AlexanderFPhO/STM32H757-FC/(list of files, drawings)

Other design files:
freerouting.dsn
