AlexanderFPhO/STM32H757-FC/FC.kicad_pcb

## KiCad design FC.kicad_pcb (2025-06-13)

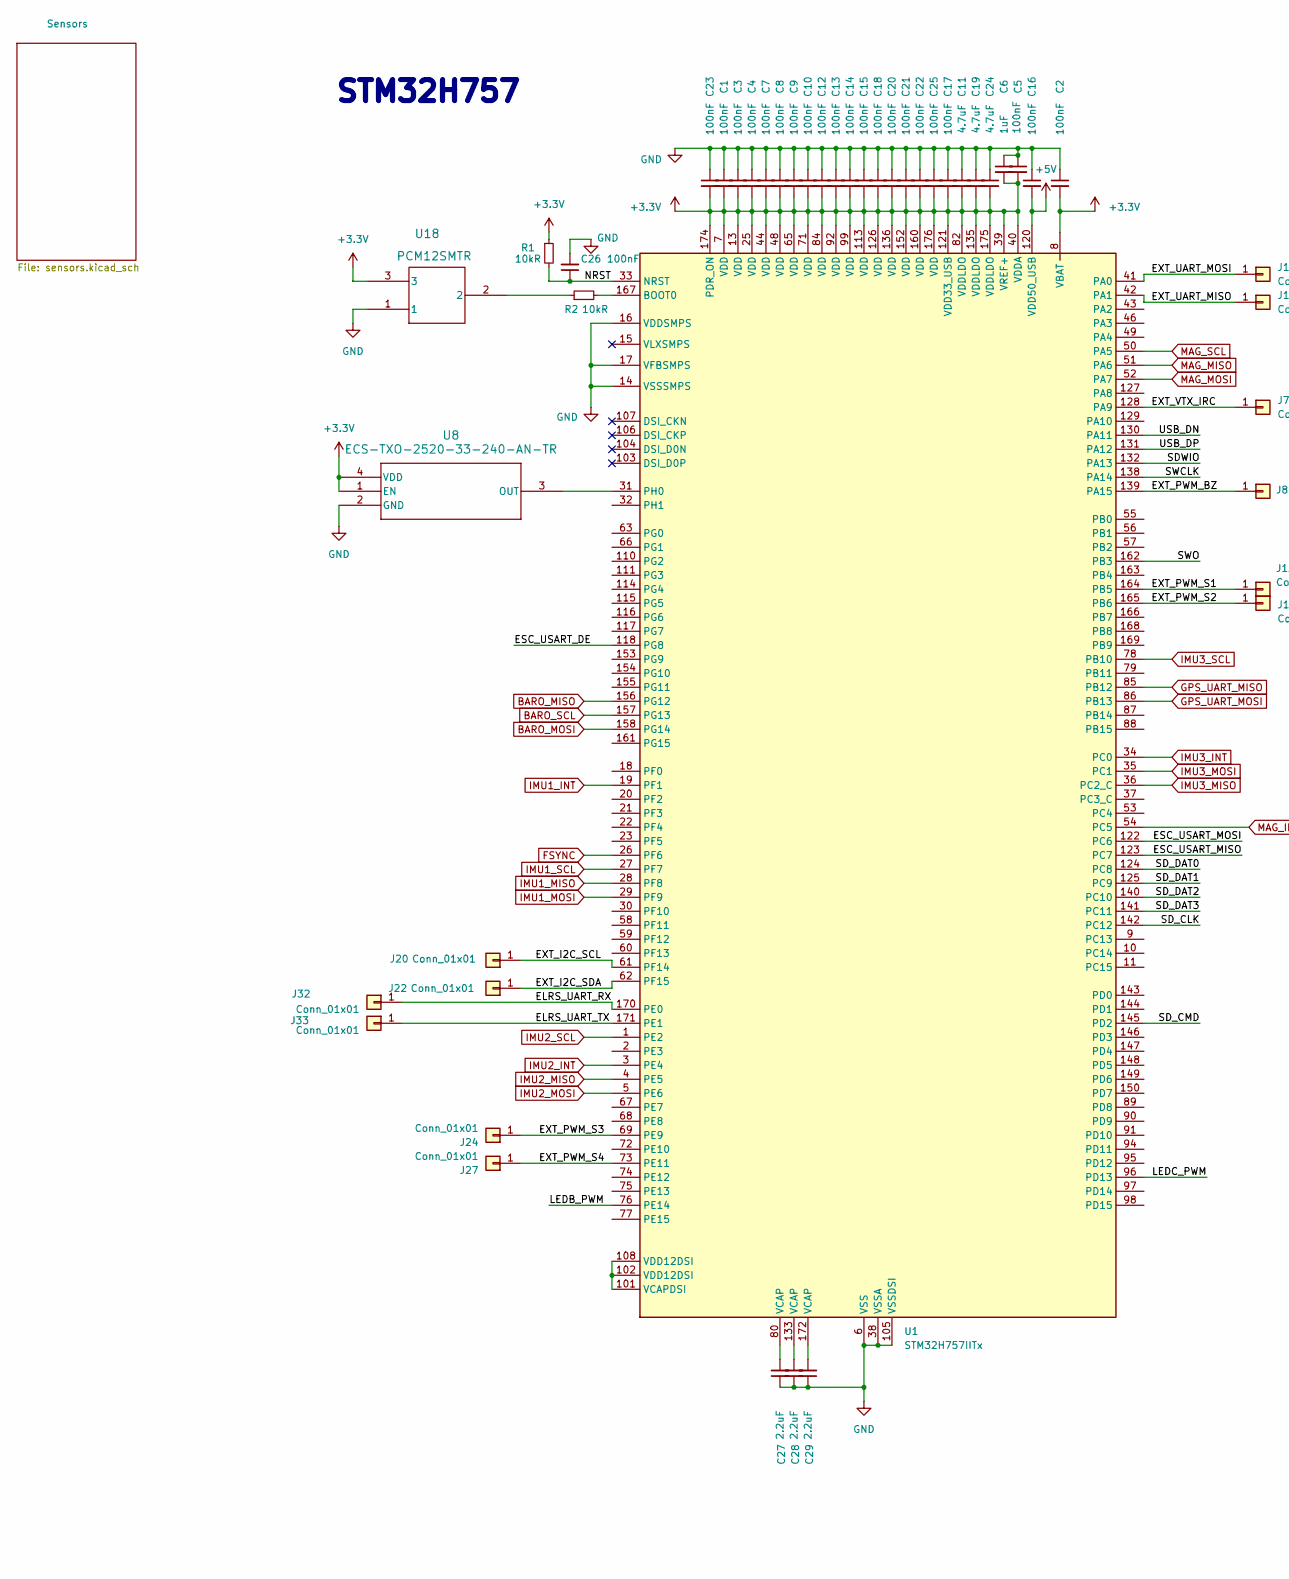
[picture p1: schematic FC.kicad_sch, Flight Controller H7, part in row 1, column 1]

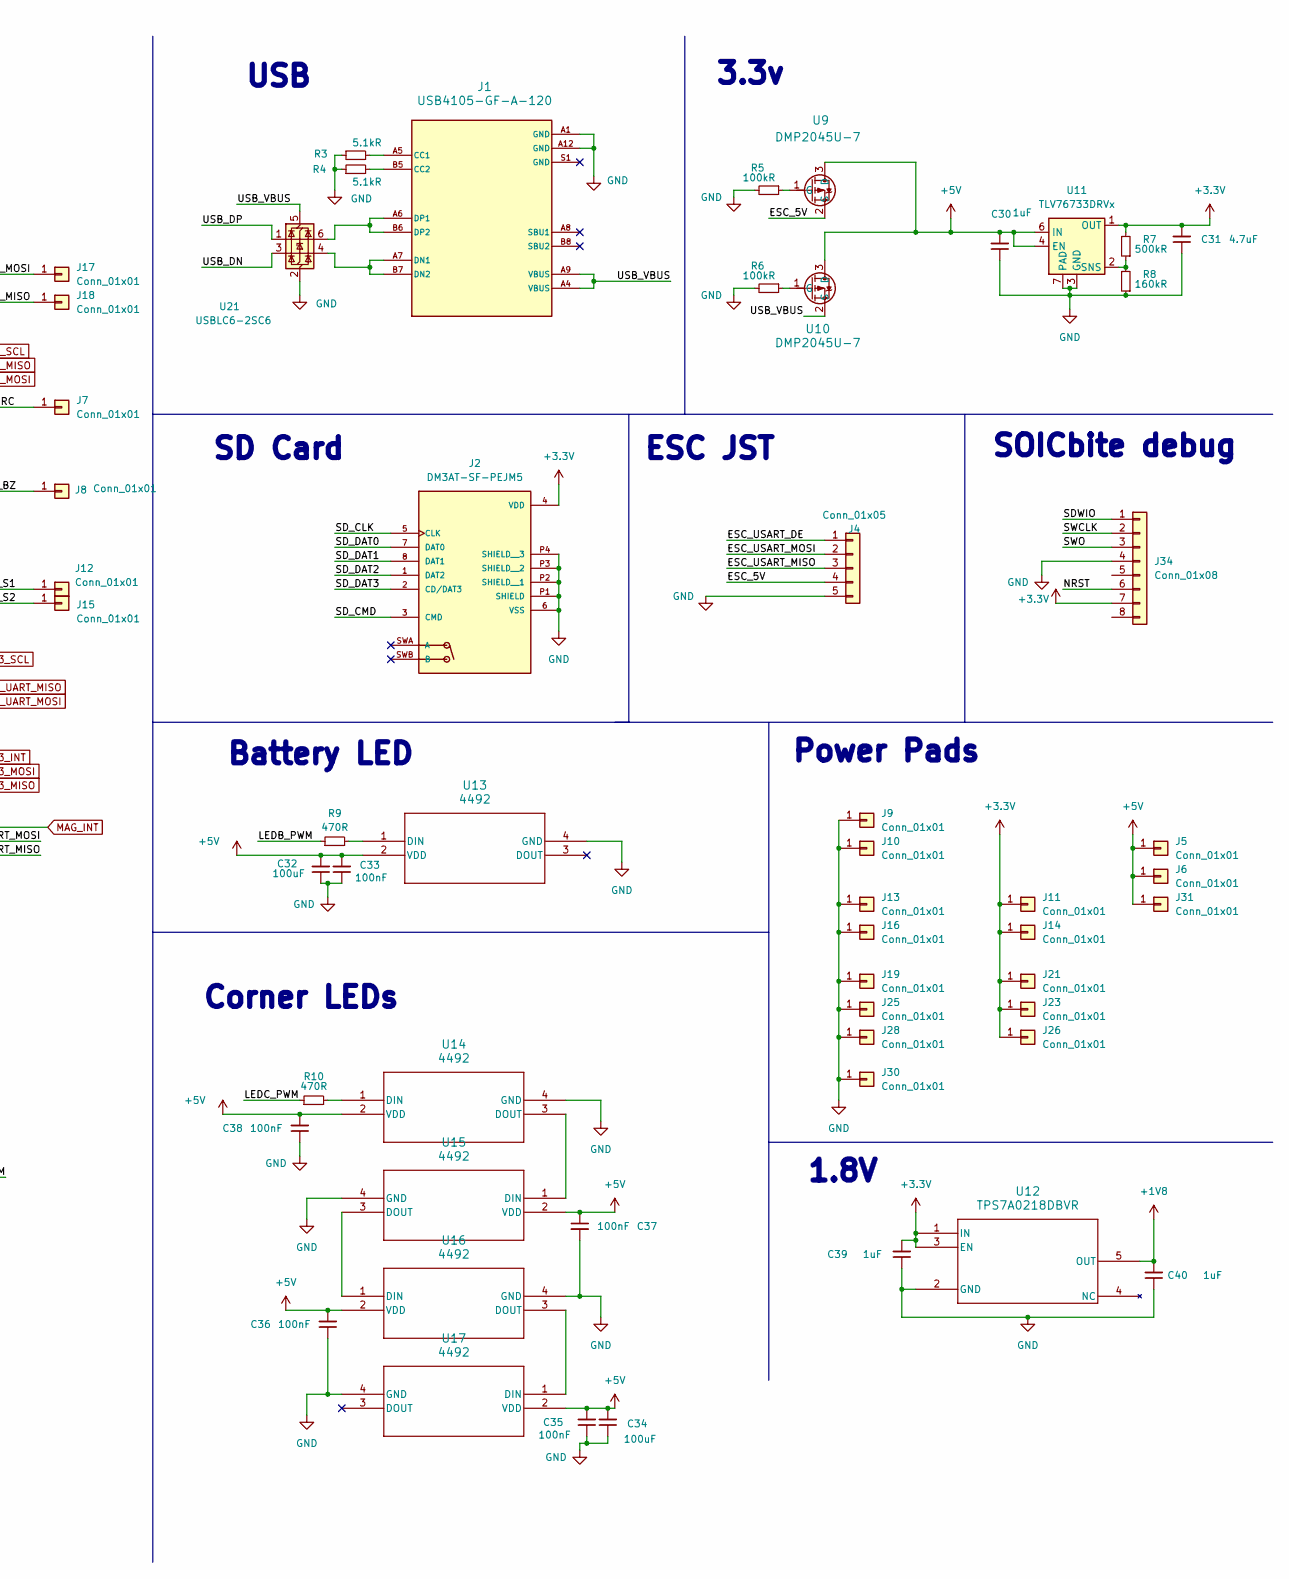
[picture p2: schematic FC.kicad_sch, Flight Controller H7, part in row 1, column 2]

Parts:
C1, C2, C3, C4, C5, C7, C8, C9, C10, C12, C13, C14, C15, C16, C17, C18, C20, C21, C22, C23, C25, C26, C33, C35, C36, C37, C38: 100nF; C_0603_1608Metric
C6, C30, C39, C40: 1uF; C_0603_1608Metric
C11, C19, C24, C31: 4.7uF; C_0603_1608Metric
C27, C28, C29: 2.2uF; C_0603_1608Metric
C32, C34: 100uF; C_0805_2012Metric
J1: USB4105-GF-A-120; USB_C_Receptacle_GCT_USB4105-xx-A_16P_TopMnt_Horizontal_NOB
J2: DM3AT-SF-PEJM5; DM3AT-SF-PEJM5_HRS_DM3AT-SF-PEJM5; PARTREV 20200913
J4: Conn_01x05; JST_ZH_S5B-ZR-SM4A-TF_1x05-1MP_P1.50mm_Horizontal
J5, J6, J7, J8, J9, J10, J11, J12, J13, J14, J15, J16, J17, J18, J19, J20, J21, J22, J23, J24, J25, J26, J27, J28, J30, J31, J32, J33: Conn_01x01; WirePad_1x01_SMD_1.4x2mm
J34: Conn_01x08; SOIC_clipProgSmall
R1, R2: 10kR; R_0603_1608Metric
R3, R4: 5.1kR; R_0603_1608Metric
R5, R6: 100kR; R_0603_1608Metric
R7: 500kR; R_0603_1608Metric
R8: 160kR; R_0603_1608Metric
R9, R10: 470R; R_0603_1608Metric
U1: STM32H757IITx; LQFP-176_24x24mm_P0.5mm
U8: ECS-TXO-2520-33-240-AN-TR; ECS-TXO-2520-33-240-AN-TR_ECS
U9, U10: DMP2045U-7; SOT-23_DIO
U11: TLV76733DRVx; WSON-6-1EP_2x2mm_P0.65mm_EP1x1.6mm_ThermalVias
U12: TPS7A0218DBVR; SOT23_DBV_TEX
U13, U14, U15, U16, U17: 4492; 4492_ADA
U18: PCM12SMTR; PCM12SMTR_CNK
U21: USBLC6-2SC6; SOT-23-6

Connections:
+1V8: C40.2, U12.5 (OUT); also elsewhere on the board
+3.3V: C1.2, C2.2, C3.2, C4.2, C5.2, C6.2, C7.2, C8.2, C9.2, C10.2, C11.2, C12.2, C13.2, C14.2, C15.2, C17.2, C18.2, C19.2, C20.2, C21.2, C22.2, C23.2, C24.2, C25.2, C31.2, C39.2, J2.4 (VDD), J11.1, J14.1, J21.1, J23.1, J26.1, J34.7, R1.1, R7.2, U1.7 (VDD), U1.8 (VBAT), U1.13 (VDD), U1.25 (VDD), U1.39 (VREF+), U1.40 (VDDA), U1.44 (VDD), U1.48 (VDD), U1.65 (VDD), U1.71 (VDD), U1.82 (VDDLDO), U1.84 (VDD), U1.92 (VDD), U1.99 (VDD), U1.113 (VDD), U1.121 (VDD33_USB), U1.126 (VDD), U1.135 (VDDLDO), U1.136 (VDD), U1.152 (VDD), U1.160 (VDD), U1.174 (PDR_ON), U1.175 (VDDLDO), U1.176 (VDD), U8.1 (EN), U8.4 (VDD), U11.1 (OUT), U12.1 (IN), U12.3 (EN), U18.3; also elsewhere on the board
+5V: C16.2, C30.2, C32.2, C33.2, C34.2, C35.2, C36.2, C37.1, C38.2, J5.1, J6.1, J31.1, U1.120 (VDD50_USB), U9.3 (D), U10.3 (D), U11.4 (EN), U11.6 (IN), U13.2 (VDD), U14.2 (VDD), U15.2 (VDD), U16.2 (VDD), U17.2 (VDD)
/ELRS_UART_RX: J32.1, U1.170 (PE0)
/ELRS_UART_TX: J33.1, U1.171 (PE1)
/ESC_5V: J4.4, U9.2 (S)
/ESC_USART_DE: J4.1, U1.118 (PG8)
/ESC_USART_MISO: J4.3, U1.123 (PC7)
/ESC_USART_MOSI: J4.2, U1.122 (PC6)
/EXT_I2C_SCL: J20.1, U1.61 (PF14)
/EXT_I2C_SDA: J22.1, U1.62 (PF15)
/EXT_PWM_BZ: J8.1, U1.139 (PA15)
/EXT_PWM_S1: J12.1, U1.164 (PB5)
/EXT_PWM_S2: J15.1, U1.165 (PB6)
/EXT_PWM_S3: J24.1, U1.69 (PE9)
/EXT_PWM_S4: J27.1, U1.73 (PE11)
/EXT_UART_MISO: J18.1, U1.42 (PA1)
/EXT_UART_MOSI: J17.1, U1.41 (PA0)
/EXT_VTX_IRC: J7.1, U1.128 (PA9)
/LEDB_PWM: R9.1, U1.76 (PE14)
/LEDC_PWM: R10.1, U1.96 (PD13)
/NRST: C26.1, J34.6, R1.2, U1.33 (NRST)
/SDWIO: J34.1, U1.132 (PA13)
/SD_CLK: J2.5 (CLK), U1.142 (PC12)
/SD_CMD: J2.3 (CMD), U1.145 (PD2)
/SD_DAT0: J2.7 (DAT0), U1.124 (PC8)
/SD_DAT1: J2.8 (DAT1), U1.125 (PC9)
/SD_DAT2: J2.1 (DAT2), U1.140 (PC10)
/SD_DAT3: J2.2 (CD/DAT3), U1.141 (PC11)
/SWCLK: J34.2, U1.138 (PA14)
/SWO: J34.3, U1.162 (PB3)
/USB_DN: U1.130 (PA11), U21.3 (I/O2)
/USB_DP: U1.131 (PA12), U21.1 (I/O1)
/USB_VBUS: J1.A4 (VBUS), J1.A9 (VBUS), U10.2 (S), U21.5 (VBUS)
BARO_MISO: U1.156 (PG12); also elsewhere on the board
BARO_MOSI: U1.158 (PG14); also elsewhere on the board
BARO_SCL: U1.157 (PG13); also elsewhere on the board
FSYNC: U1.26 (PF6); also elsewhere on the board
GND: C1.1, C2.1, C3.1, C4.1, C5.1, C6.1, C7.1, C8.1, C9.1, C10.1, C11.1, C12.1, C13.1, C14.1, C15.1, C16.1, C17.1, C18.1, C19.1, C20.1, C21.1, C22.1, C23.1, C24.1, C25.1, C26.2, C27.1, C28.1, C29.1, C30.1, C31.1, C32.1, C33.1, C34.1, C35.1, C36.1, C37.2, C38.1, C39.1, C40.1, J1.A1 (GND), J1.A12 (GND), J2.6 (VSS), J2.P1 (SHIELD), J2.P2 (SHIELD__1), J2.P3 (SHIELD__2), J2.P4 (SHIELD__3), J4.5, J9.1, J10.1, J13.1, J16.1, J19.1, J25.1, J28.1, J30.1, J34.4, R3.1, R4.1, R5.2, R6.2, R8.1, U1.6 (VSS), U1.12 (VSS), U1.14 (VSSSMPS), U1.16 (VDDSMPS), U1.17 (VFBSMPS), U1.24 (VSS), U1.38 (VSSA), U1.45 (VSS), U1.47 (VSS), U1.64 (VSS), U1.70 (VSS), U1.81 (VSS), U1.83 (VSS), U1.93 (VSS), U1.100 (VSS), U1.105 (VSSDSI), U1.109 (VSSDSI), U1.112 (VSS), U1.119 (VSS), U1.134 (VSS), U1.137 (VSS), U1.151 (VSS), U1.159 (VSS), U1.173 (VSS), U8.2 (GND), U11.3 (GND), U11.5 (GND), U11.7 (PAD), U12.2 (GND), U13.4 (GND), U14.4 (GND), U15.4 (GND), U16.4 (GND), U17.4 (GND), U18.1, U21.2 (GND); also elsewhere on the board
GPS_UART_MISO: U1.85 (PB12); also elsewhere on the board
GPS_UART_MOSI: U1.86 (PB13); also elsewhere on the board
IMU1_INT: U1.19 (PF1); also elsewhere on the board
IMU1_MISO: U1.28 (PF8); also elsewhere on the board
IMU1_MOSI: U1.29 (PF9); also elsewhere on the board
IMU1_SCL: U1.27 (PF7); also elsewhere on the board
IMU2_INT: U1.3 (PE4); also elsewhere on the board
IMU2_MISO: U1.4 (PE5); also elsewhere on the board
IMU2_MOSI: U1.5 (PE6); also elsewhere on the board
IMU2_SCL: U1.1 (PE2); also elsewhere on the board
IMU3_INT: U1.34 (PC0); also elsewhere on the board
IMU3_MISO: U1.36 (PC2_C); also elsewhere on the board
IMU3_MOSI: U1.35 (PC1); also elsewhere on the board
IMU3_SCL: U1.78 (PB10); also elsewhere on the board
MAG_INT: U1.54 (PC5); also elsewhere on the board
MAG_MISO: U1.51 (PA6); also elsewhere on the board
MAG_MOSI: U1.52 (PA7); also elsewhere on the board
MAG_SCL: U1.50 (PA5); also elsewhere on the board
unnamed: C27.2, U1.80 (VCAP)
unnamed: C28.2, U1.133 (VCAP)
unnamed: C29.2, U1.172 (VCAP)
unnamed: J1.A5 (CC1), R3.2
unnamed: J1.B5 (CC2), R4.2
unnamed: J1.A7 (DN1), J1.B7 (DN2), U21.4 (I/O2)
unnamed: J1.A6 (DP1), J1.B6 (DP2), U21.6 (I/O1)
unnamed: R2.1, U18.2
unnamed: R2.2, U1.167 (BOOT0)
unnamed: U1.31 (PH0), U8.3 (OUT)
unnamed: U1.101 (VCAPDSI), U1.102 (VDD12DSI), U1.108 (VDD12DSI)
unnamed: R5.1, U9.1 (G)
unnamed: R6.1, U10.1 (G)
unnamed: R7.1, R8.2, U11.2 (SNS)
unnamed: R9.2, U13.1 (DIN)
unnamed: R10.2, U14.1 (DIN)
unnamed: U14.3 (DOUT), U15.1 (DIN)
unnamed: U15.3 (DOUT), U16.1 (DIN)
unnamed: U16.3 (DOUT), U17.1 (DIN)

Notes on the sheet:
ESC JST
USB
Corner LEDs
1.8V
SOICbite debug
Power Pads
Battery LED
SD Card
STM32H757
3.3v

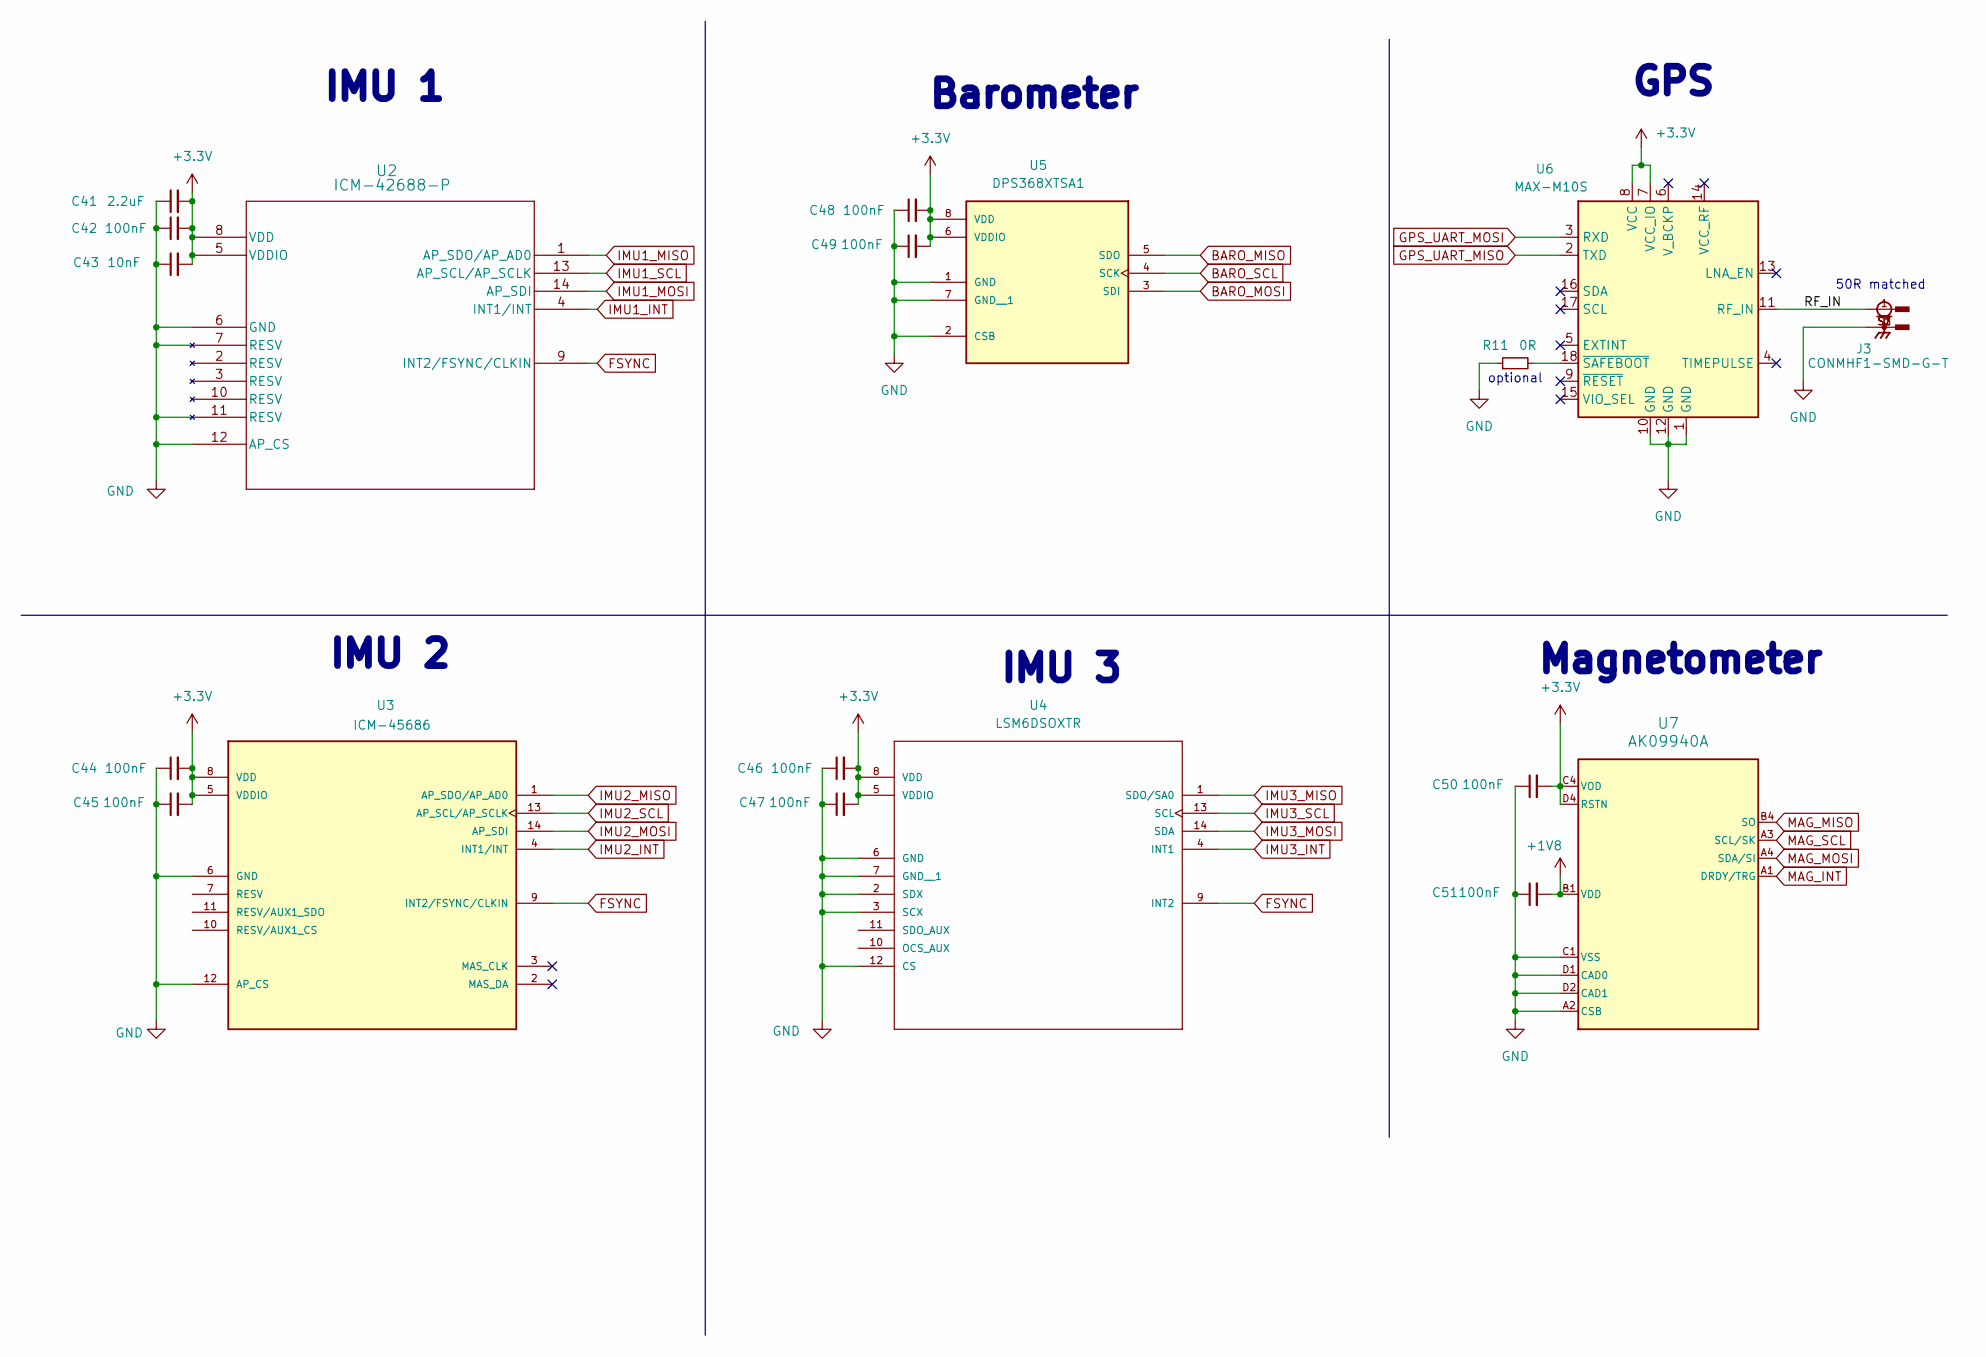
[picture p3: schematic sensors.kicad_sch, Flight Controller H7]

Parts:
C41: 2.2uF; C_0603_1608Metric
C42, C44, C45, C46, C47, C48, C49, C50, C51: 100nF; C_0603_1608Metric
C43: 10nF; C_0603_1608Metric
J3: CONMHF1-SMD-G-T; CONMHF1-SMD-G-T_LINX_CONMHF1-SMD-G-T
R11: 0R; R_0603_1608Metric
U2: ICM-42688-P; LGA14_2P5X3X0P91_TDK
U3: ICM-45686; ICM-45686_IC_ICM-45686; PARTREV 0.2
U4: LSM6DSOXTR; LSM6DSOXTR_PQFN50P250X300X86-14N; PARTREV 3.0
U5: DPS368XTSA1; DPS368XTSA1_XDCR_DPS368XTSA1
U6: MAX-M10S; ublox_MAX
U7: AK09940A; LGA11_1p6x1p6x0p58_AKM

Connections:
+1V8: C51.2, U7.B1 (VDD); also elsewhere on the board
+3.3V: C41.2, C42.2, C43.2, C44.2, C45.2, C46.2, C47.2, C48.2, C49.2, C50.2, U2.5 (VDDIO), U2.8 (VDD), U3.5 (VDDIO), U3.8 (VDD), U4.5 (VDDIO), U4.8 (VDD), U5.6 (VDDIO), U5.8 (VDD), U6.7 (VCC_IO), U6.8 (VCC), U7.C4 (VOD), U7.D4 (RSTN); also elsewhere on the board
/Sensors/RF_IN: J3.1, U6.11 (RF_IN)
BARO_MISO: U5.5 (SDO); also elsewhere on the board
BARO_MOSI: U5.3 (SDI); also elsewhere on the board
BARO_SCL: U5.4 (SCK); also elsewhere on the board
FSYNC: U2.9 (INT2/FSYNC/CLKIN), U3.9 (INT2/FSYNC/CLKIN), U4.9 (INT2); also elsewhere on the board
GND: C41.1, C42.1, C43.1, C44.1, C45.1, C46.1, C47.1, C48.1, C49.1, C50.1, C51.1, J3.S1, J3.S2, J3.S3, R11.1, U2.6 (GND), U2.7 (RESV), U2.11 (RESV), U2.12 (AP_CS), U3.6 (GND), U3.12 (AP_CS), U4.2 (SDX), U4.3 (SCX), U4.6 (GND), U4.7 (GND__1), U4.12 (CS), U5.1 (GND), U5.2 (CSB), U5.7 (GND__1), U6.1 (GND), U6.10 (GND), U6.12 (GND), U7.A2 (CSB), U7.C1 (VSS), U7.D1 (CAD0), U7.D2 (CAD1); also elsewhere on the board
GPS_UART_MISO: U6.2 (TXD); also elsewhere on the board
GPS_UART_MOSI: U6.3 (RXD); also elsewhere on the board
IMU1_INT: U2.4 (INT1/INT); also elsewhere on the board
IMU1_MISO: U2.1 (AP_SDO/AP_AD0); also elsewhere on the board
IMU1_MOSI: U2.14 (AP_SDI); also elsewhere on the board
IMU1_SCL: U2.13 (AP_SCL/AP_SCLK); also elsewhere on the board
IMU2_INT: U3.4 (INT1/INT); also elsewhere on the board
IMU2_MISO: U3.1 (AP_SDO/AP_AD0); also elsewhere on the board
IMU2_MOSI: U3.14 (AP_SDI); also elsewhere on the board
IMU2_SCL: U3.13 (AP_SCL/AP_SCLK); also elsewhere on the board
IMU3_INT: U4.4 (INT1); also elsewhere on the board
IMU3_MISO: U4.1 (SDO/SA0); also elsewhere on the board
IMU3_MOSI: U4.14 (SDA); also elsewhere on the board
IMU3_SCL: U4.13 (SCL); also elsewhere on the board
MAG_INT: U7.A1 (DRDY/TRG); also elsewhere on the board
MAG_MISO: U7.B4 (SO); also elsewhere on the board
MAG_MOSI: U7.A4 (SDA/SI); also elsewhere on the board
MAG_SCL: U7.A3 (SCL/SK); also elsewhere on the board
unnamed: R11.2, U6.18 (~SAFEBOOT)

Notes on the sheet:
Magnetometer
IMU 3
Barometer
50R matched
IMU 2
optional
IMU 1
GPS

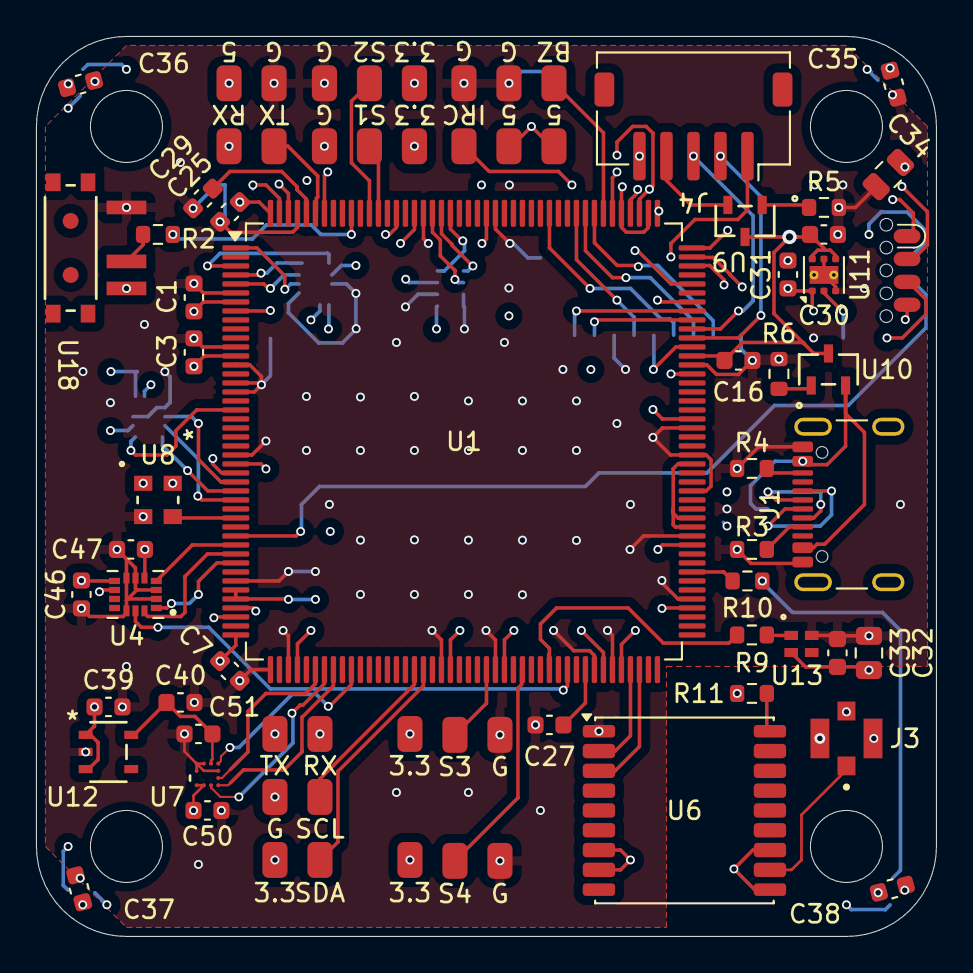
[picture p4: board FC.kicad_pcb from above]

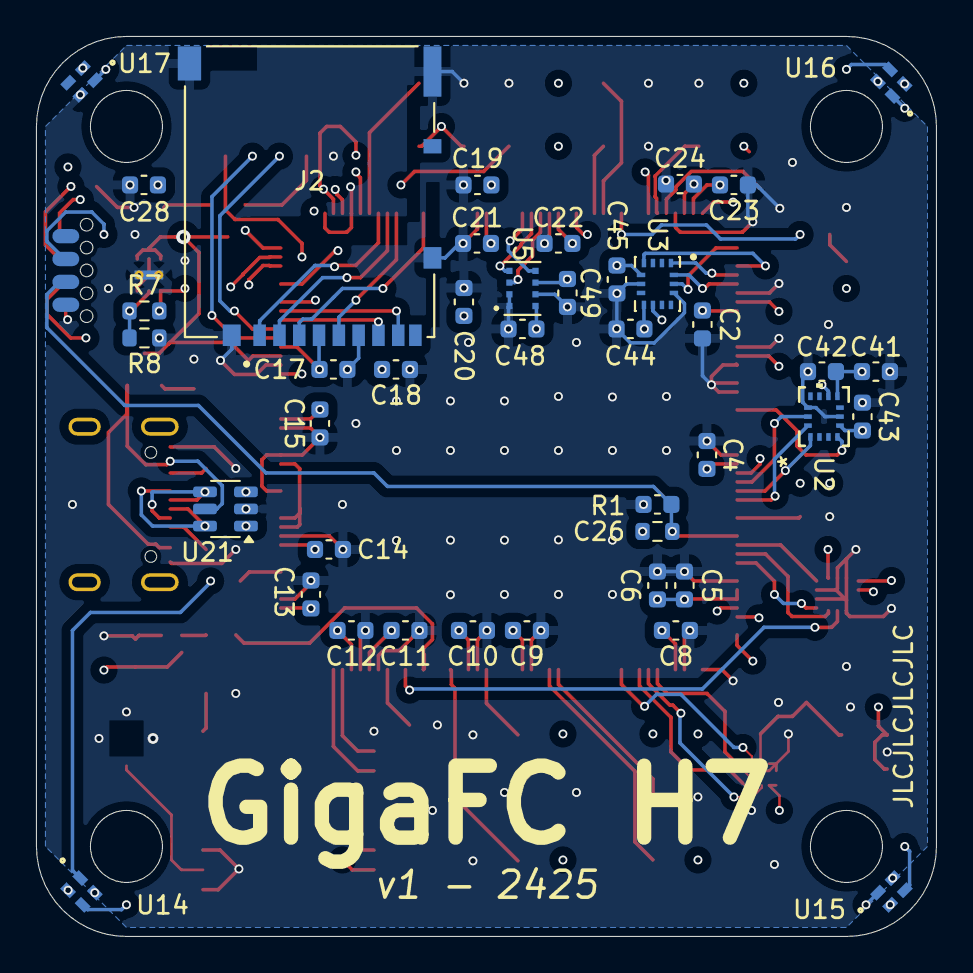
[picture p5: board FC.kicad_pcb from below]

Board: 6 copper layers, 50.0 x 50.0 mm, 114 parts (41 on the bottom side), 78 nets.
