AlexanderFPhO/STM32H757-FC/STM32/FC.ioc

Mcu.UserName=STM32H757IITx
PA0.Signal=UART4_TX
PA1.Signal=UART4_RX
PA10.Signal=LPUART1_RX
PA11.Signal=USB_OTG_FS_DM
PA12.Signal=USB_OTG_FS_DP
PA5.Signal=SPI1_SCK
PA6.Signal=SPI1_MISO
PA7.Signal=SPI1_MOSI
PA9.Signal=LPUART1_TX
PB10.Signal=SPI2_SCK
PB12.Signal=UART5_RX
PB13.Signal=UART5_TX
PB5.Signal=S_TIM3_CH2
PB6.Signal=S_TIM4_CH1
PB8.Signal=S_TIM4_CH3
PC0.Signal=GPXTI0
PC1.Signal=SPI2_MOSI
PC10.Signal=SDMMC1_D2
PC11.Signal=SDMMC1_D3
PC12.Signal=SDMMC1_CK
PC2_C.Signal=SPI2_MISO
PC5.Signal=GPXTI5
PC6.Signal=USART6_TX
PC7.Signal=USART6_RX
PC8.Signal=SDMMC1_D0
PC9.Signal=SDMMC1_D1
PD13.Signal=S_TIM4_CH2
PD2.Signal=SDMMC1_CMD
PE0.Signal=UART8_RX
PE1.Signal=UART8_TX
PE11.Signal=S_TIM1_CH2
PE14.Signal=S_TIM1_CH4
PE2.Signal=SPI4_SCK
PE4.Signal=GPXTI4
PE5.Signal=SPI4_MISO
PE6.Signal=SPI4_MOSI
PE9.Signal=S_TIM1_CH1
PF1.Signal=GPXTI1
PF14.Signal=I2C4_SCL
PF15.Signal=I2C4_SDA
PF6.Signal=S_TIM16_CH1
PF7.Signal=SPI5_SCK
PF8.Signal=SPI5_MISO
PF9.Signal=SPI5_MOSI
PG12.Signal=SPI6_MISO
PG13.Signal=SPI6_SCK
PG14.Signal=SPI6_MOSI
PG8.Signal=USART6_DE
