AlexanderFPhO/STM32H757-FC/(commit log)

2025-06-04 remove old files
    [IMU+Baro.kicad_sch, USB+PWR.kicad_sch, video.kicad_sch]
2025-06-07 V2 with feedback
    [FC.kicad_pcb, FC.kicad_sch, sensors.kicad_sch]
2025-06-09 V1 manufacturing
    [FC-B_Cu.gbl, FC-B_Cu.gbr, FC-B_Mask.gbr, FC-B_Mask.gbs, FC-B_Paste.gbp, FC-B_Paste.gbr, FC-B_Silkscreen.gbo, FC-B_Silkscreen.gbr]
2025-06-13 A few changes for v1 manufacturing and STMCubeMX generation
    [FC-B_Cu.gbl, FC-B_Mask.gbs, FC-B_Paste.gbp, FC-B_Silkscreen.gbo, FC-Edge_Cuts.gm1, FC-F_Cu.gtl, FC-F_Mask.gts, FC-F_Paste.gtp]
