AlexanderFPhO/STM32H757-FC/(notices)

Notices in the files:
STM32/CM7/Core/Src/main.c:
Copyright (c) 2025 STMicroelectronics.
All rights reserved.
This software is licensed under terms that can be found in the LICENSE file
